kris2475/High-Voltage-PV-Powered-Gesture-Detection-System/Li_Ion_vs_EDLC.jpg

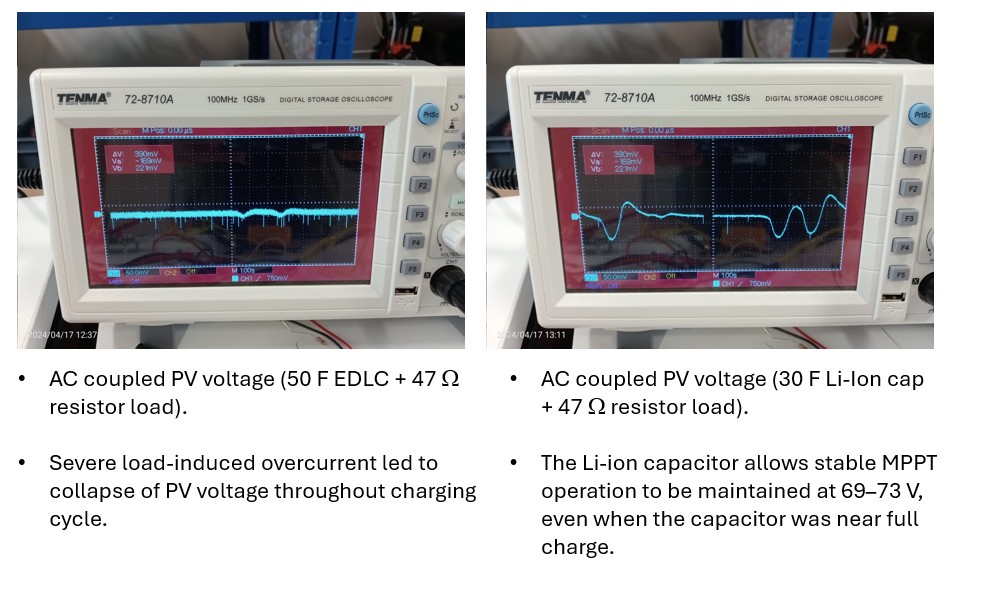
Li_Ion_vs_EDLC.jpg
