kris2475/High-Voltage-PV-Powered-Gesture-Detection-System/Shadow_Gesture_Detection_System.pdf

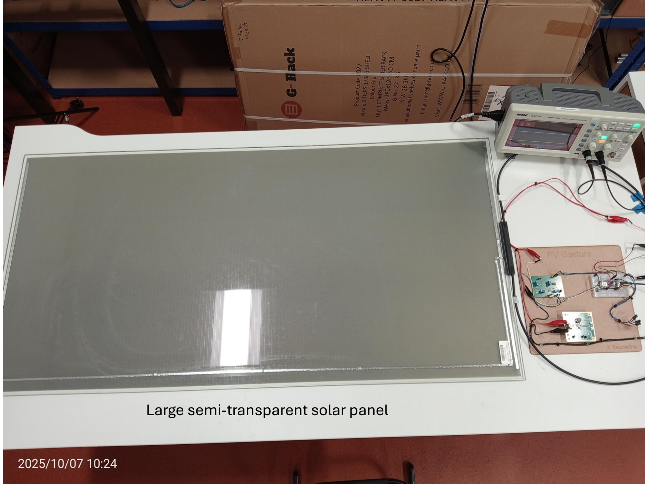
[picture p2: page 1]

Large semi-transparent solar panel

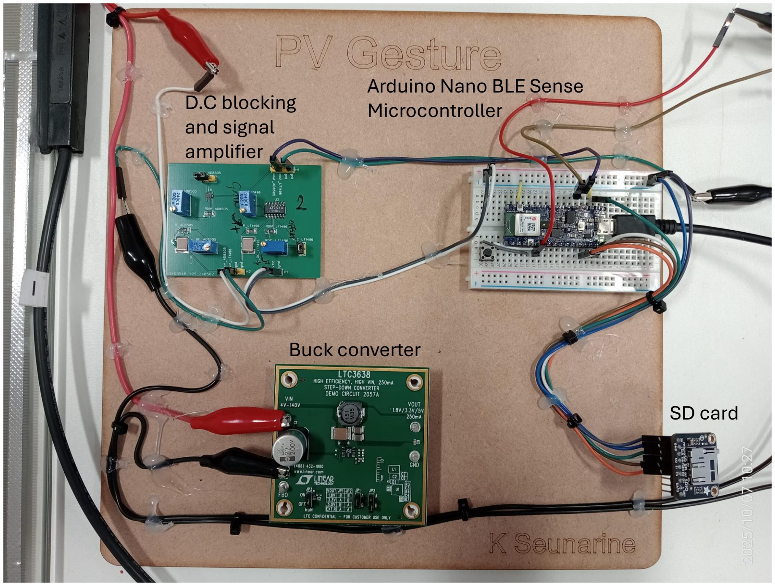
[picture p3: page 2]

D.C blocking
and signal
amplifier

Buck converter

SD card

Arduino Nano BLE Sense
Microcontroller

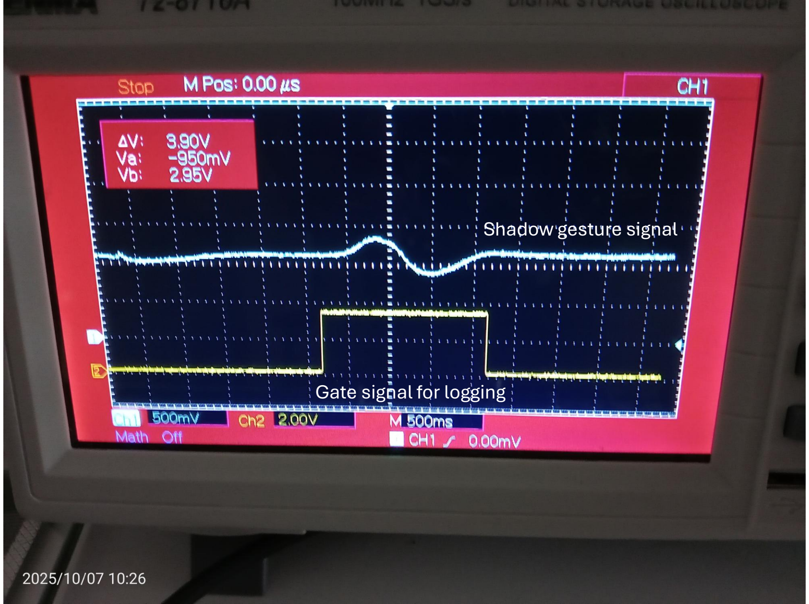
[picture p4: page 3]

Shadow gesture signal

Gate signal for logging
