kris2475/High-Voltage-PV-Powered-Gesture-Detection-System/Circuit_schematic.jpg

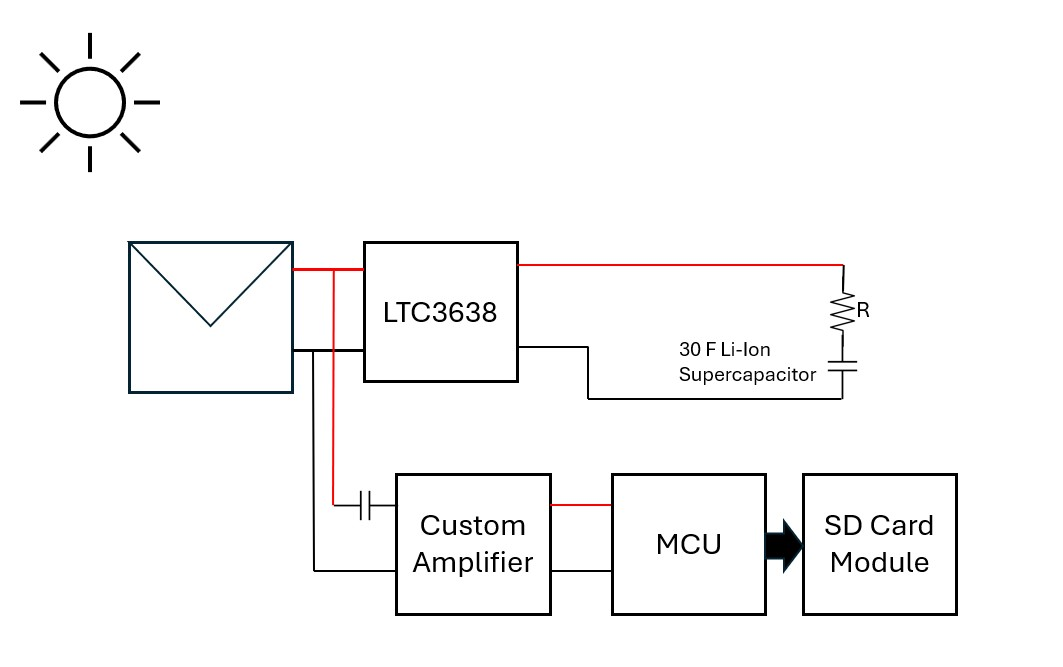
Circuit_schematic.jpg
