kris2475/High-Voltage-PV-Powered-Gesture-Detection-System/Shadow Gestures.png

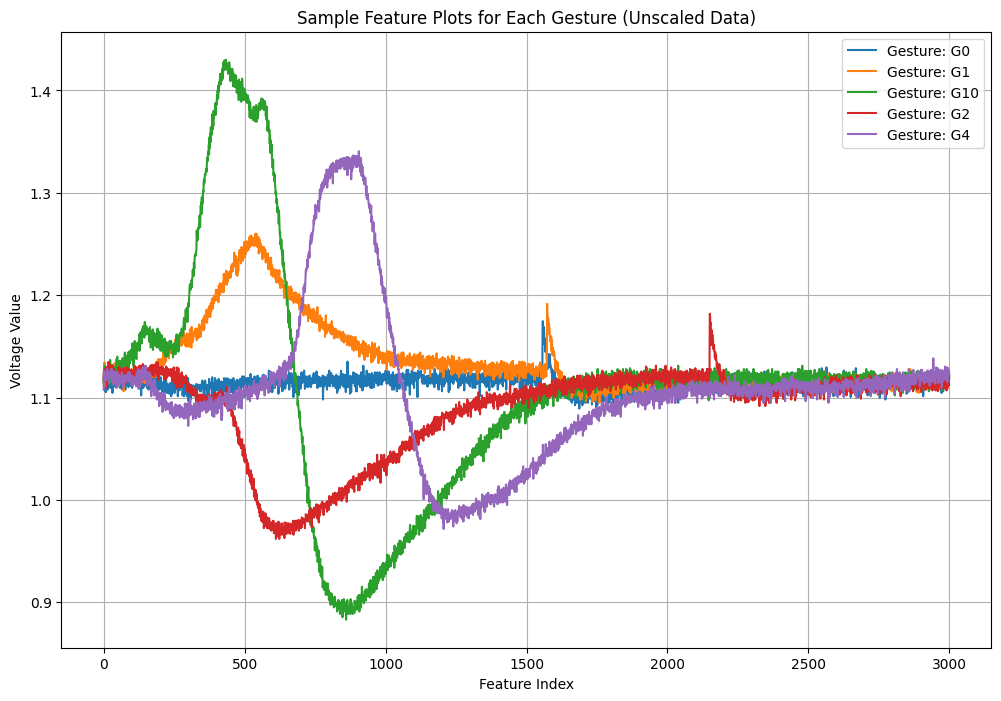
Shadow Gestures.png
