kris2475/High-Voltage-PV-Powered-Gesture-Detection-System/BOM_OpAmpPCB_2025-10-07.csv

ID | Name | Designator | Footprint | Quantity | Manufacturer Part | Manufacturer | Supplier | Supplier Part | Price
1 | 10uF | C_DC_AD8505,C_DC_LT1496 | C2220 | 2 | CGA9N3X7S2A106K230KB |  | LCSC | C2168961 | 5.348
2 | Header-Male-2.54_1x4 | H1,H2 | HDR-TH_4P-P2.54-V-M | 2 | B-2100S04P-A110 |  | LCSC | C124378 | 0.046
3 | Header-Female-2.54_1x2 | P1,VCC_AD8505,VCC_LT1496 | HDR-TH_2P-P2.54-V-F | 3 | 2.54-1*2P母 |  | LCSC | C49661 | 0.038
4 | 2 MOhm | RDC_AD8505,RDC_LT1496 | RES-ADJ-TH_L9.5-W4.8-P2.54_3296Y | 2 | 3296Y-1-202LF |  | LCSC | C5359580 | 0.808
5 | 1 MOhm | RDIV_AD8505,RDIV_LT1496 | R1206 | 2 |  |  | LCSC | C3016974 | 0.003
6 | 1.5 MOhm | RF_AD8505,RF_LT1496 | RES-ADJ-TH_L9.5-W4.8-P2.54_3296Y | 2 | 3296Y-1-202LF |  | LCSC | C5359580 | 0.808
7 | 500 kOhm | R_AD8505,R_LT1496 | R1206 | 2 |  |  | LCSC | C3016974 | 0.003
8 | AD8505ARJZ-R7 | U1 | SOT-23-5_L2.9-W1.6-P0.95-LS2.8-BL | 1 | AD8505ARJZ-R7 |  | LCSC | C652907 | 2.059
9 | LT1496HS#PBF | U2 | SO-14_L8.9-W3.9-P1.27-LS6.0-BL | 1 | LT1496HS#PBF |  | LCSC | C664041 | 8.051
