kris2475/High-Voltage-PV-Powered-Gesture-Detection-System/(commit log)

2025-10-09 Update and rename G0_09102025.csv to csv/G0_09102025.csv
    [G0_09102025.csv]
2025-10-09 Update and rename G10_09102025.csv to csv/G10_09102025.csv
    [G10_09102025.csv]
2025-10-09 Update and rename G1_09102025.csv to csv/G1_09102025.csv
    [G1_09102025.csv]
2025-10-09 Update and rename G2_09102025.csv to csv/G2_09102025.csv
    [G2_09102025.csv]
2025-10-09 Update and rename csv/G2_09102025.csv to csv/csv/G2_09102025.csv
    [G2_09102025.csv]
2025-10-09 Update and rename G4_09102025.csv to csv/G4_09102025.csv
    [G4_09102025.csv]
2025-10-09 Update and rename csv/csv/G2_09102025.csv to csv/G2_09102025.csv
    [G2_09102025.csv]
